Lancelotdb/Linefollower/readme.md

# LineFollower


<br />
<br />
# Specifications
<br />
<strong>Microcontroller:</strong> ATmega328P 
<br />
<strong>Motors:</strong> GA12-N20, 800TPM
<br />
<strong>H-bridge:</strong> Adafruit DRV8833
<br />
<strong>Sensors:</strong> Pololu QTR-8A
<br />
<strong>Batteries:</strong> Efest IMR 18650 35A
<br />
<strong>Wireless communication:</strong> HC-05
<br />
<strong>Distance sensor - motors:</strong> 95mm
<br />
<strong>Weight:</strong>
<br />
<strong>Speed:</strong> 0,66 m/s
<br />
