Lancelotdb/Linefollower/Bill of materials.xlsx

Bill of materials plan B
Volgnummer | Naam | Omschrijving | Nieuw/recup | Kostprijs/stuk | Aantal | Subtotaal
1 | Arduino Leonardo | Microcontroller | Recup | 25.37 | 1 | 25.37
2 | Adafruit DRV8833 | H-brug | Nieuw | 6.5 | 1 | 6.5
3 | HC-05 | Draadloze communicatie | Nieuw | 6.99 | 1 | 6.99
4 | QTR-8A | IR-sensor array | Nieuw | 18.75 | 1 | 18.75
5 | 18650 Batterijhouder | Batterijhouder dubbel | Nieuw | 1.39 | 1 | 1.39
6 | DC gearbox motor | N20, 6VDC, 600TPM | Nieuw | 5.32 | 2 | 10.64
7 | Balwiel | N20 balwiel | Nieuw | 1.49 | 1 | 1.49
8 | Weerstanden | 100stuks, 10 soorten | Nieuw | 2.99 | 1 | 2.99
9 | Drukknop | Intterupt schakelaar | Nieuw | 0.4 | 1 | 0.4
9 | Efest 18650 | Li-Ion batterijen | Recup | 9.95 | 2 | 19.9
10 | Efest 18650 lader | Oplader 18650 | Recup | 11.99 | 1 | 11.99
11 | Tuimelschakelaar | Start/stop schakelaar | Recup | 4.99 | 1 | 4.99
12 | Breadboard | Circuit board | Recup | 6.99 | 1 | 6.99
13 | Dupont kabels | verbindingsdraden | Recup | 2.99 | 1 | 2.99
14 | Leds | Signaallamp aan/uit | Recup | 0.21 | 2 | 0.42
15 | Wielen | Pololu 32x7 | Nieuw | 11.6 | 1 | 11.6
16 | Multiplex plaat | Chasis | Recup | 9.66 | 1 | 9.66
17 | Bouten met moer | M4 x 20 | Recup | 0.15 | 2 | 0.3
18 | Elastiek 60 x1,5 | 60 x1,5 | Recup | 0.01 | 1 | 0.01
19 | Hot glue | Patroon | Recup | 1.49 | 1 | 1.49
20 | Dubbelzijdige plakband | Tesa dubbelzijdig | Recup | 12.99 | 1 | 12.99
21 | Soldeertin | Soldeer middel | Recup | 4.99 | 1 | 4.99
 |  |  |  |  | Totaal: | 162.84
