Lancelotdb/Linefollower/technische tekeningen/elektronisch/Schema start stop interrupt.pdf

Rp

## Aan/uit

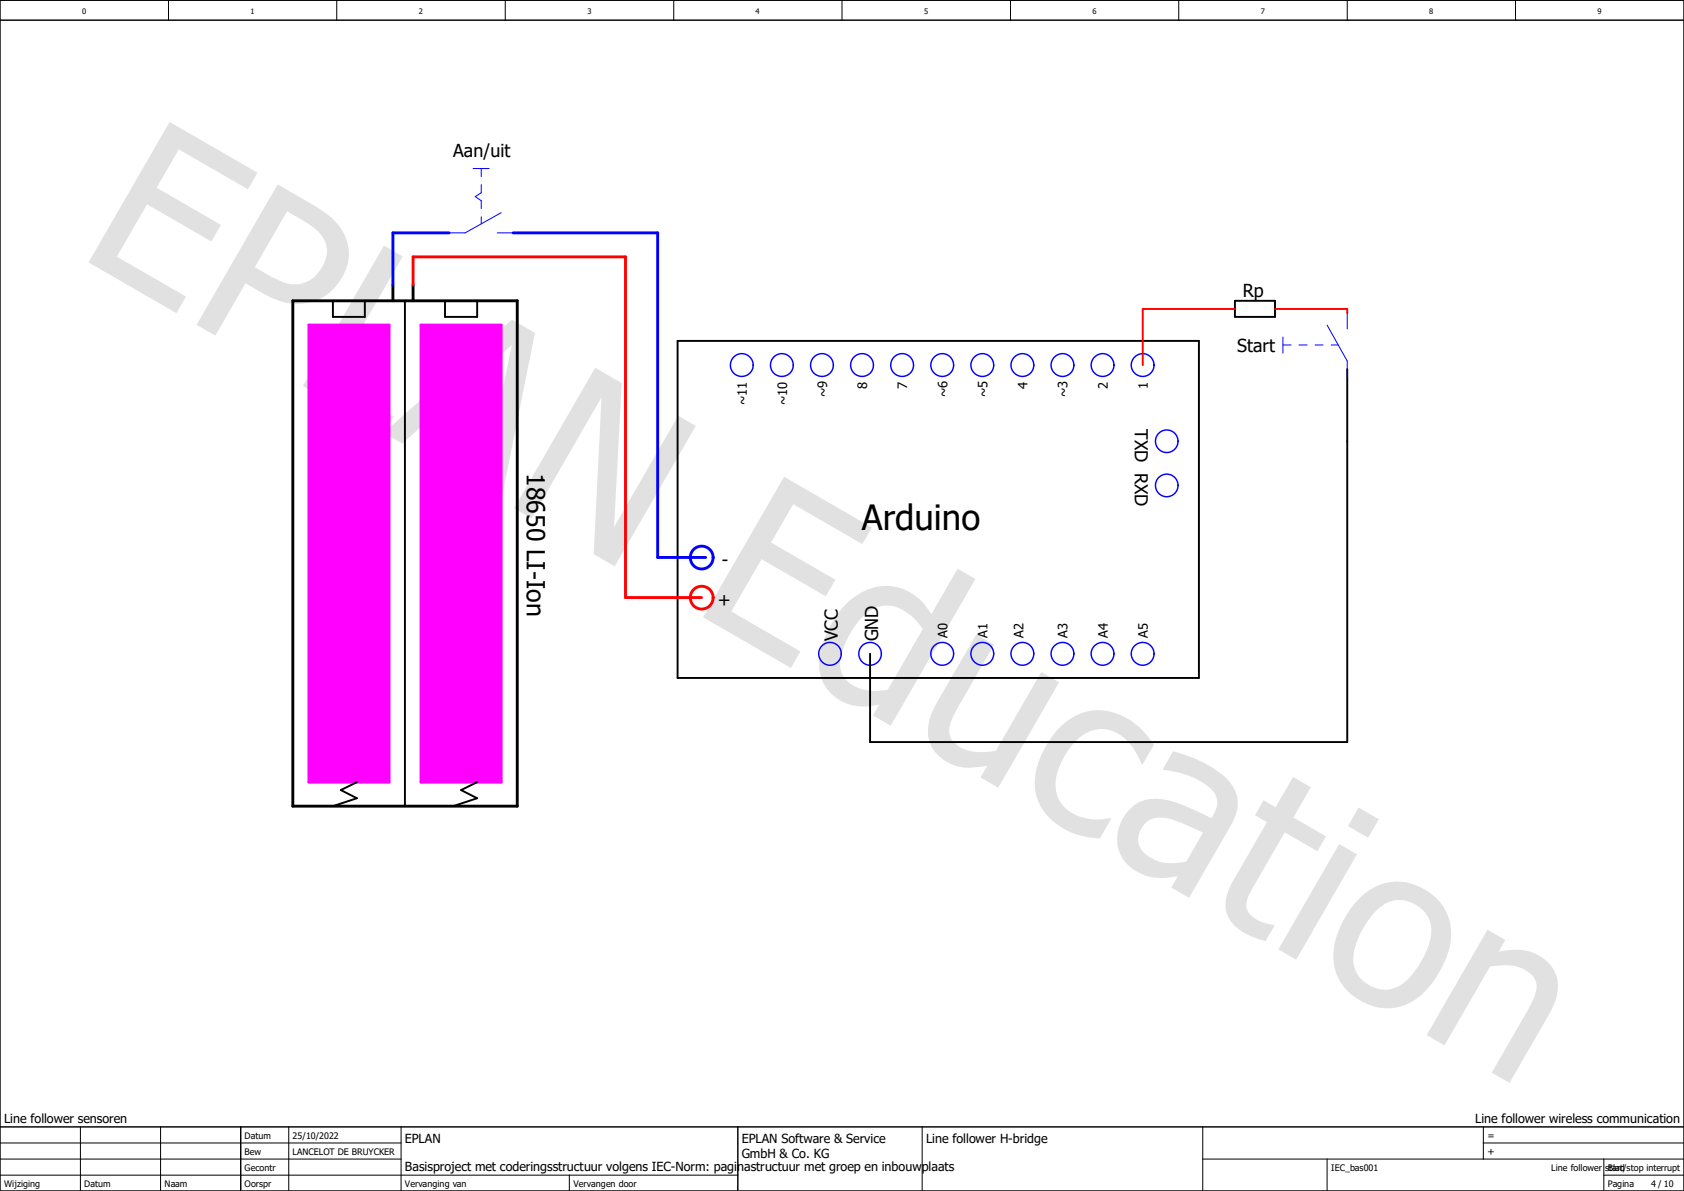
[picture p11: page 1]
Arduino ~⁵; 2 VCC GND A0A1A2A3A4A5 1; - ¹⁸⁶⁵⁰ LI-Ion; RXD TXD; Start

Line follower sensoren

Line follower wireless communication

Datum | 25/10/2022 | EPLAN Basisproject met coderingsstructuur volgens IEC-Norm: paginastructuur met groep en inbouwplaats | EPLAN Software & Service GmbH & Co. KG | Line follower H-bridge | =
Bew | LANCELOT DE BRUYCKER | | | | +
Gecontr | | | | | IEC_bas001 Line follower start/stop interrupt | Blad

Wijziging | Datum | Naam | Oorspr | | Vervanging van | Vervangen door | | | | Pagina 4 / 10
