Lancelotdb/Linefollower/technische tekeningen/elektronisch/Schema wireless communication.pdf

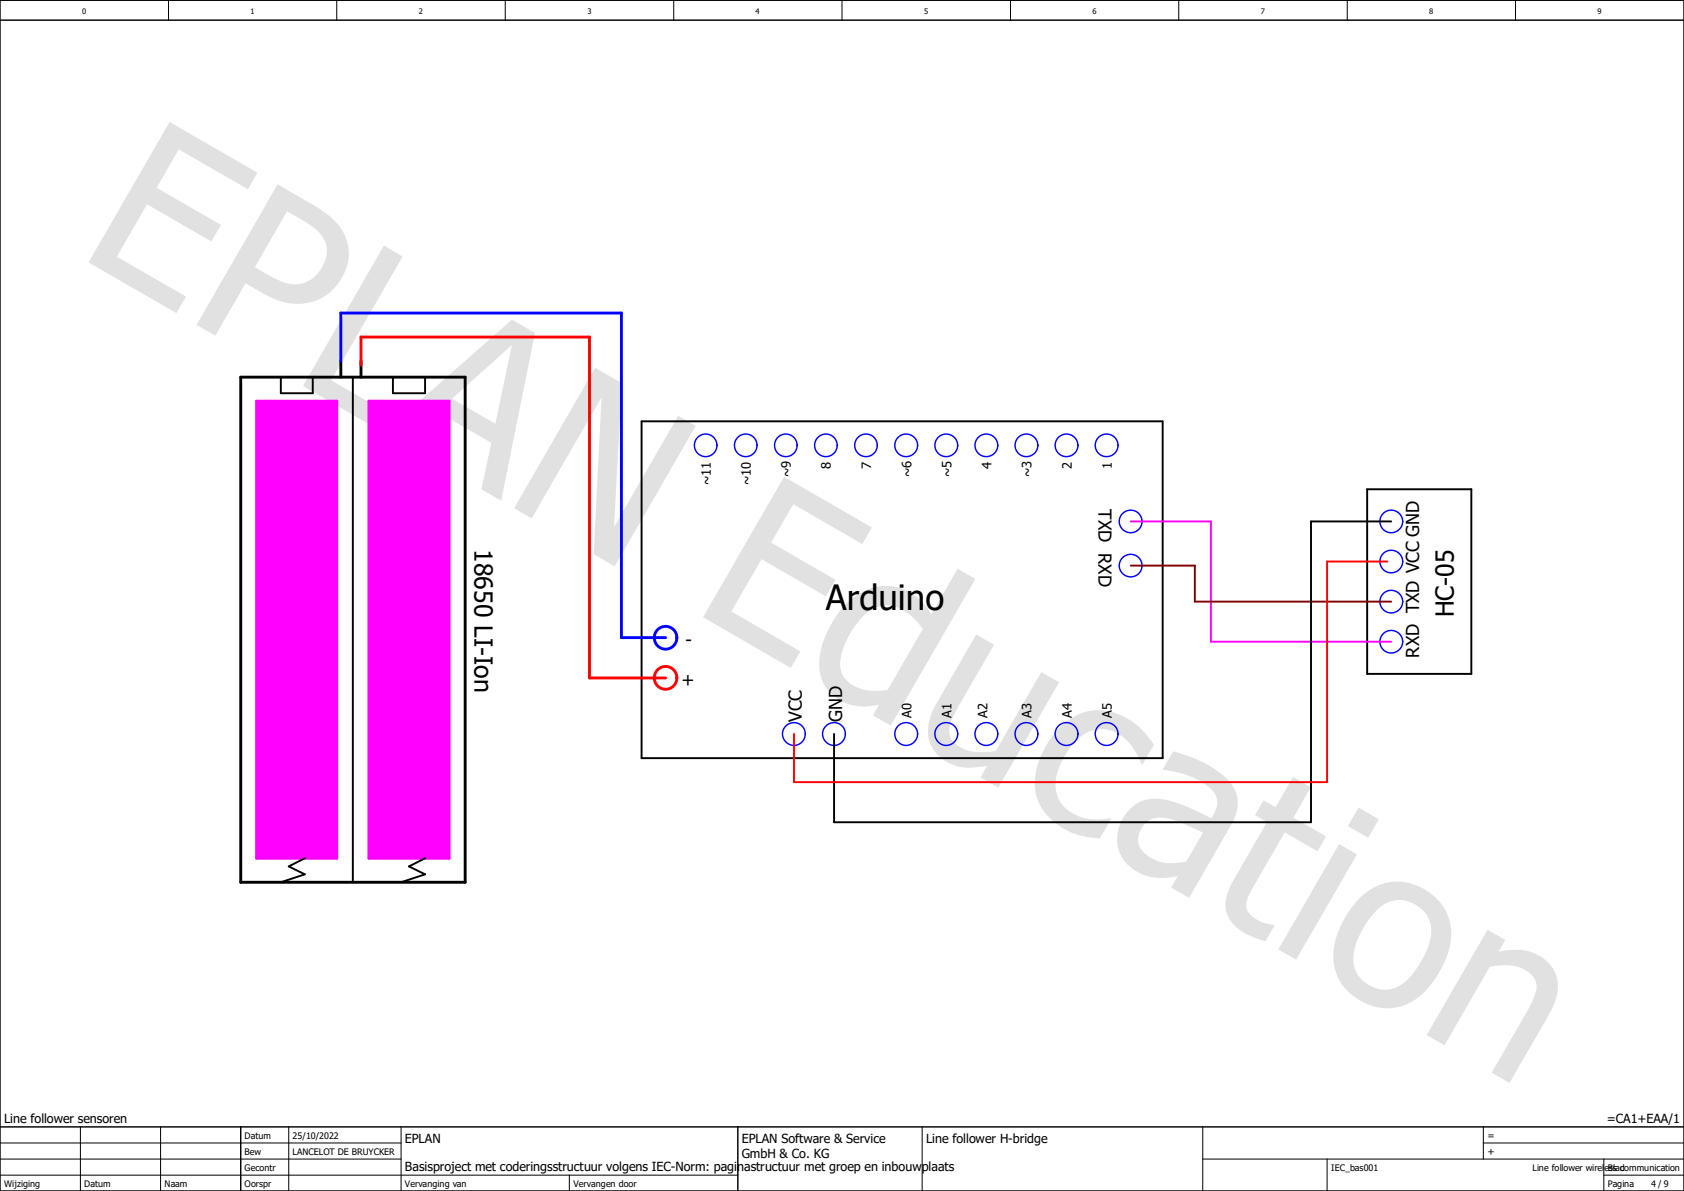
[picture p12: page 1]
=CA1+EAA/1; Arduino ~⁵; 2 VCC GND A0A1A2A3A4A5 1; - ¹⁸⁶⁵⁰ LI-Ion; RXD TXD; RXD TXD GND VCC HC⁻05

Line follower sensoren

Datum | 25/10/2022 | EPLAN Basisproject met coderingsstructuur volgens IEC-Norm: paginastructuur met groep en inbouwplaats | EPLAN Software & Service GmbH & Co. KG | Line follower H-bridge | =
Bew | LANCELOT DE BRUYCKER | | | | +
Gecontr | | | | | IEC_bas001 Line follower wireless communication | Blad

Wijziging | Datum | Naam | Oorspr | | Vervanging van | Vervangen door | | | | Pagina 4 / 9
