Lancelotdb/Linefollower/technische tekeningen/elektronisch/Schema H-bridge.pdf

## Aout Bout

## GND

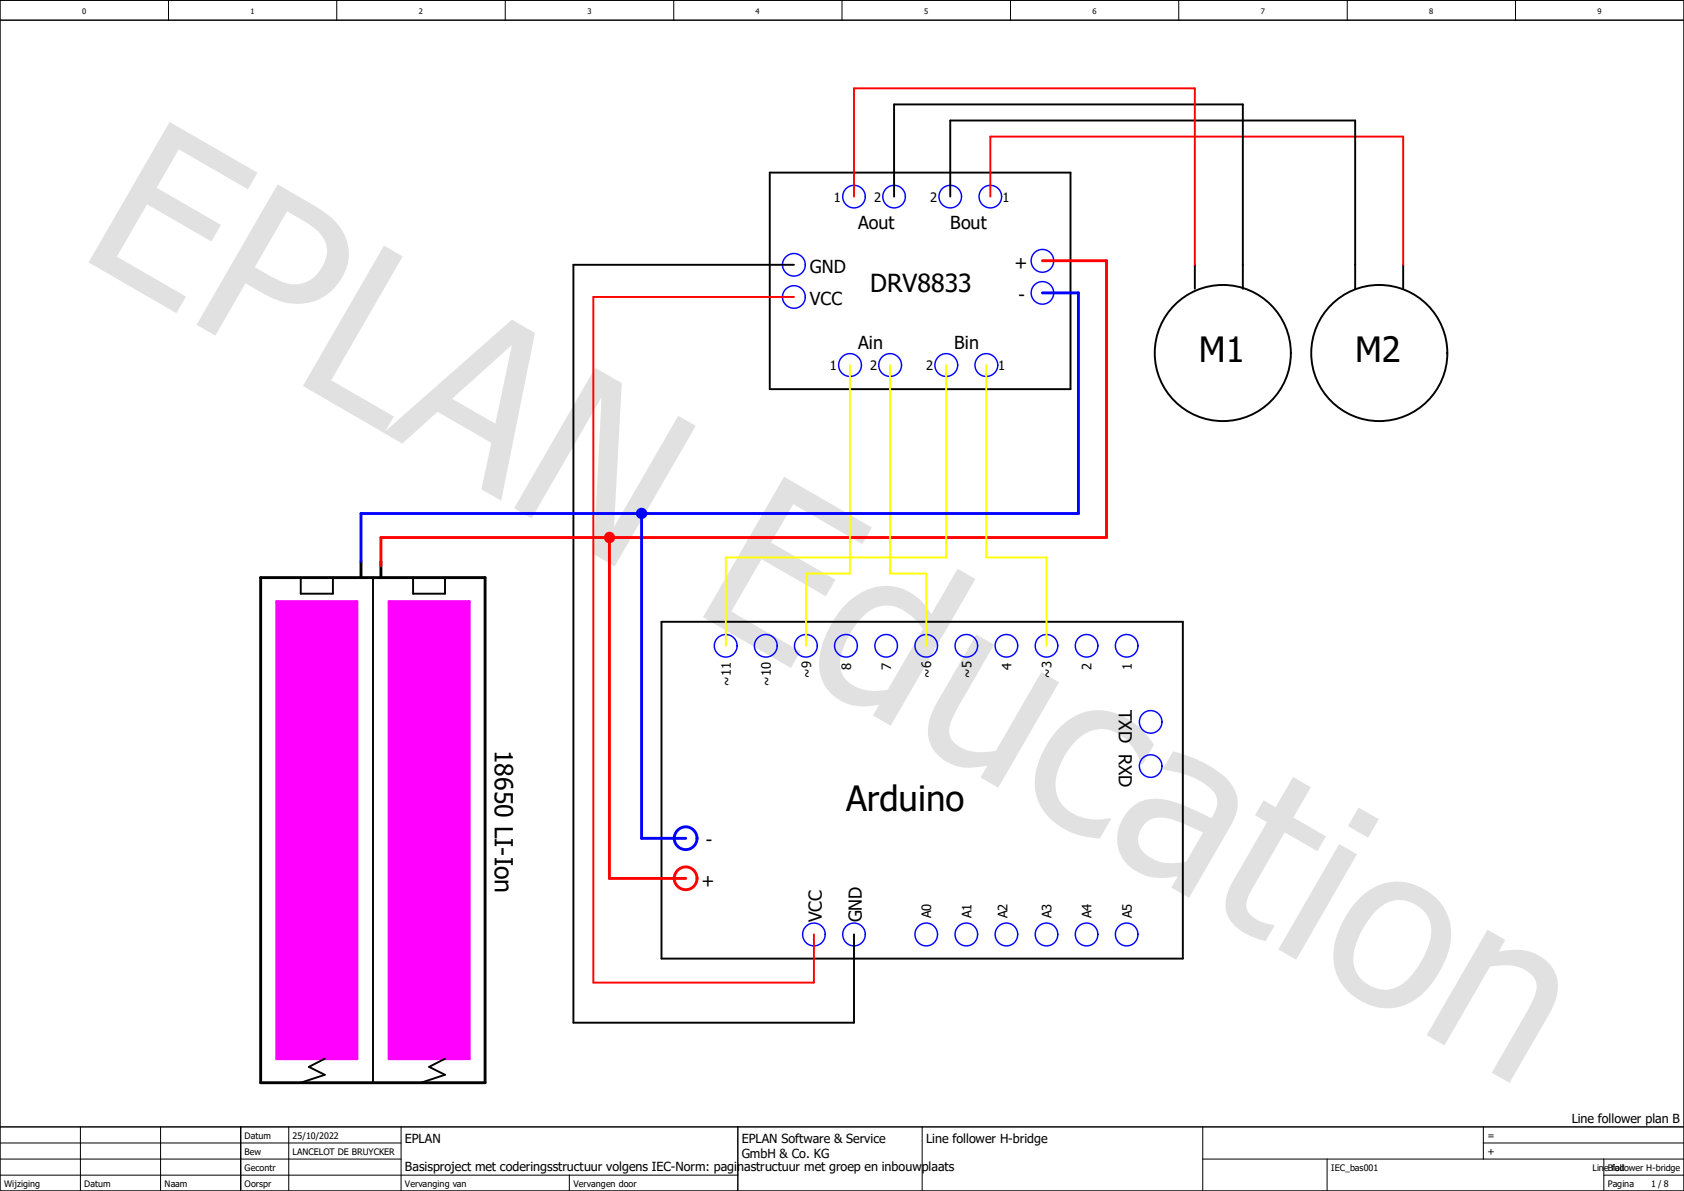
[picture p13: page 1]
Arduino; VCC; - DRV8833~⁵; 2 VCC GND A0A1A2A3A4A5 1; Ain; Bin; RXD TXD

- ¹⁸⁶⁵⁰ LI-Ion

Line follower plan B

Datum | 25/10/2022 | EPLAN Basisproject met coderingsstructuur volgens IEC-Norm: paginastructuur met groep en inbouwplaats | EPLAN Software & Service GmbH & Co. KG | Line follower H-bridge | =
Bew | LANCELOT DE BRUYCKER | | | | +
Gecontr | | | | | IEC_bas001 Line follower H-bridge | Blad

Wijziging | Datum | Naam | Oorspr | | Vervanging van | Vervangen door | | | | Pagina 1 / 8
