Lancelotdb/Linefollower/technische tekeningen/elektronisch/Schema QTR8A.pdf

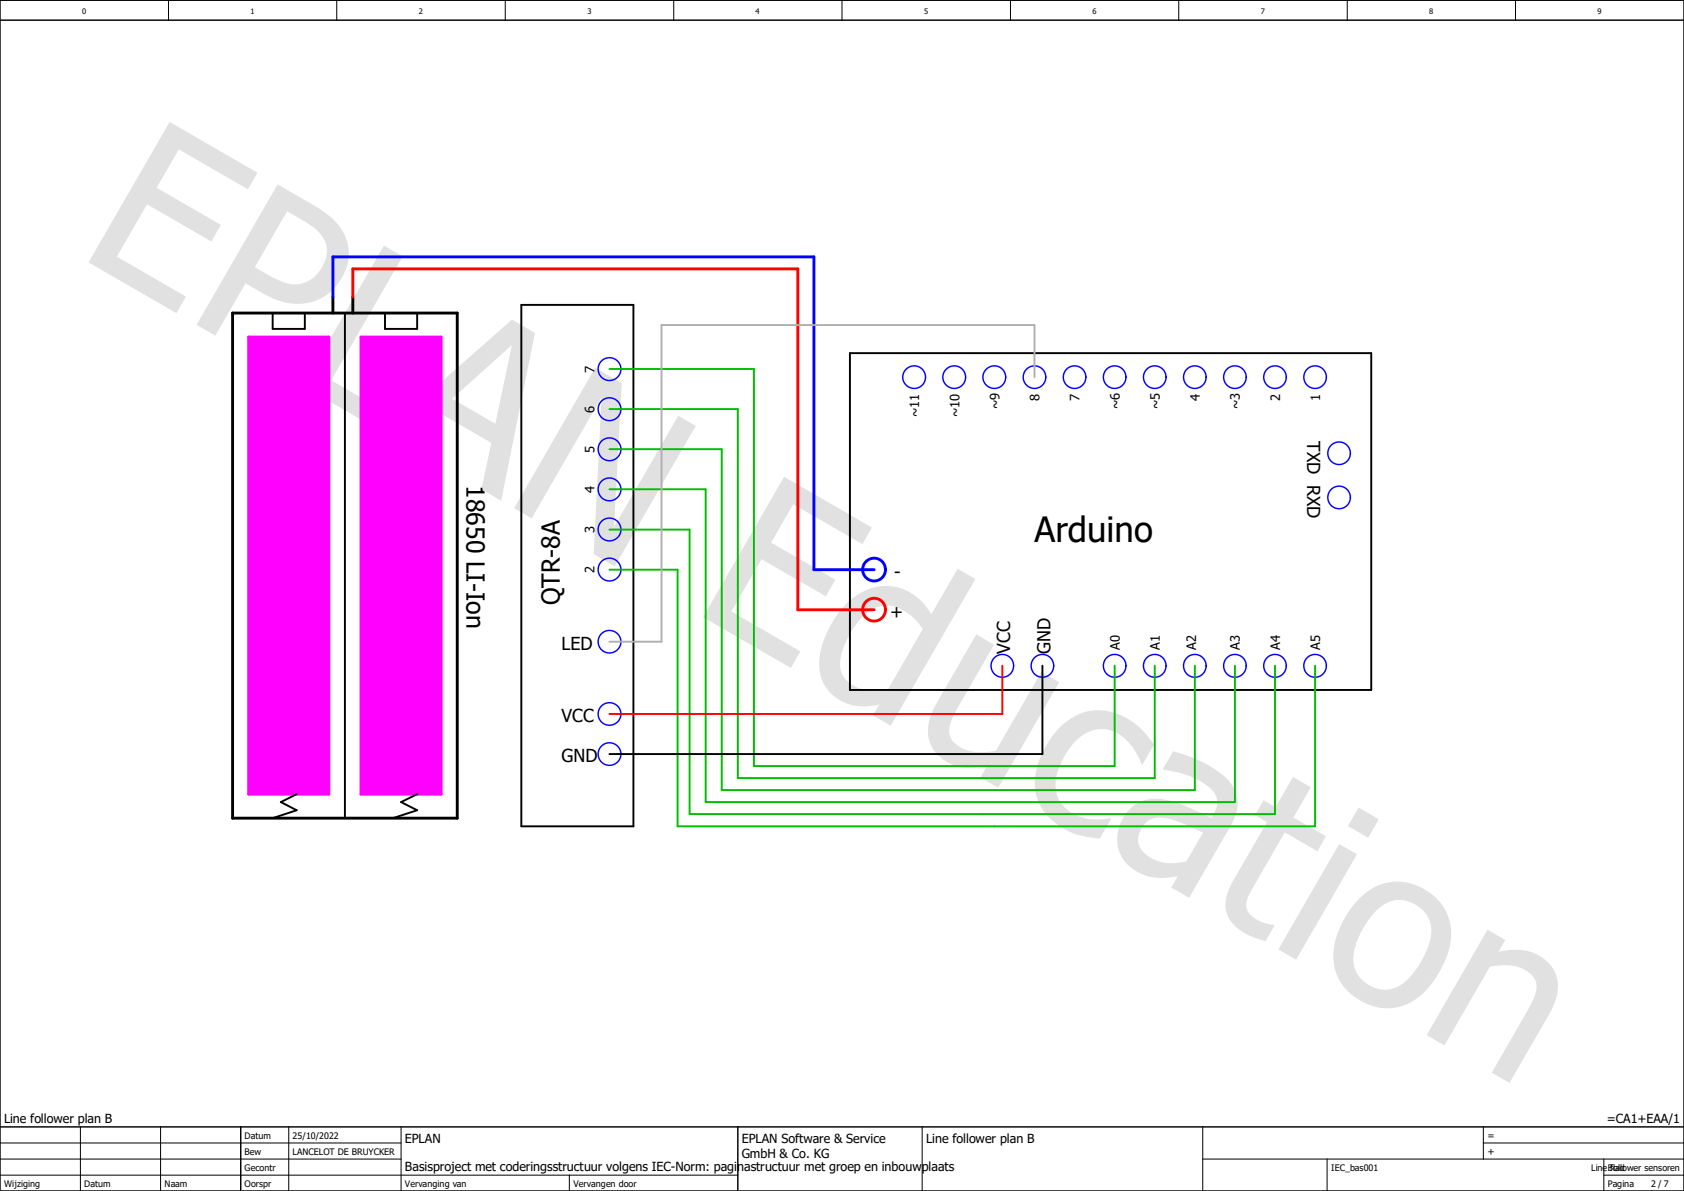
[picture p14: page 1]
=CA1+EAA/1; Arduino 2 3 4 5 6 7; LED; VCC; GND QTR⁻⁸A; 2 VCC GND A0A1A2A3A4A5 1; - ¹⁸⁶⁵⁰ LI-Ion; RXD TXD

Line follower plan B

Datum | 25/10/2022 | EPLAN Basisproject met coderingsstructuur volgens IEC-Norm: paginastructuur met groep en inbouwplaats | EPLAN Software & Service GmbH & Co. KG | Line follower plan B | =
Bew | LANCELOT DE BRUYCKER | | | | +
Gecontr | | | | | IEC_bas001 Line follower sensoren | Blad

Wijziging | Datum | Naam | Oorspr | | Vervanging van | Vervangen door | | | | Pagina 2 / 7
