Lancelotdb/Linefollower/technische tekeningen/elektronisch/Schema plan B.pdf

## Aout Bout

## GND

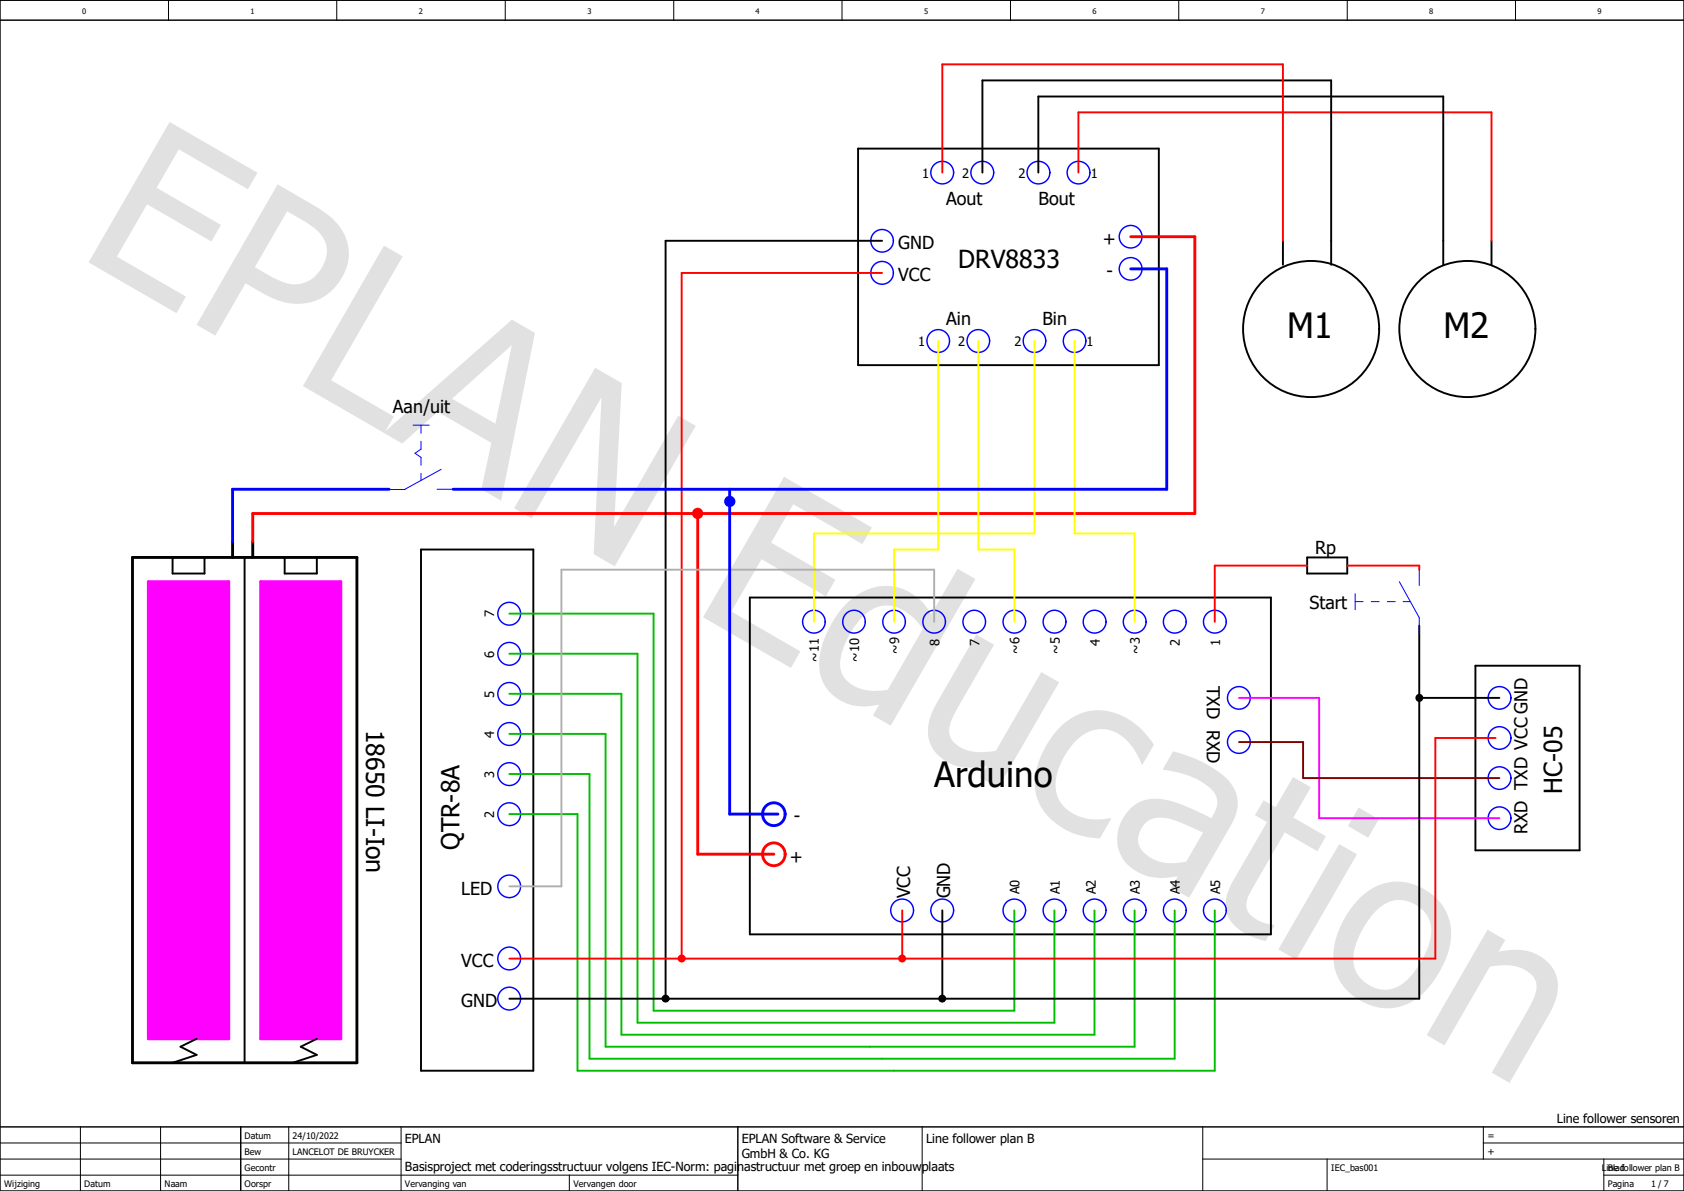
[picture p15: page 1]
Arduino; VCC; LED; DRV8833~⁵; 2 VCC GND A0A1A2A3A4A5 1; Ain; Bin; RXD TXD; RXD TXD GND VCC HC⁻05; Aan/uit; Start

- ¹⁸⁶⁵⁰ LI-Ion
GND QTR⁻⁸A

Line follower sensoren

Datum | 24/10/2022 | EPLAN Basisproject met coderingsstructuur volgens IEC-Norm: paginastructuur met groep en inbouwplaats | EPLAN Software & Service GmbH & Co. KG | Line follower plan B | =
Bew | LANCELOT DE BRUYCKER | | | | +
Gecontr | | | | | IEC_bas001 | Line follower plan B Blad

Wijziging | Datum | Naam | Oorspr | | Vervanging van | Vervangen door | | | | Pagina 1 / 7
